Matthew-Bon/imx_pequena/notes/sd_boot.PNG

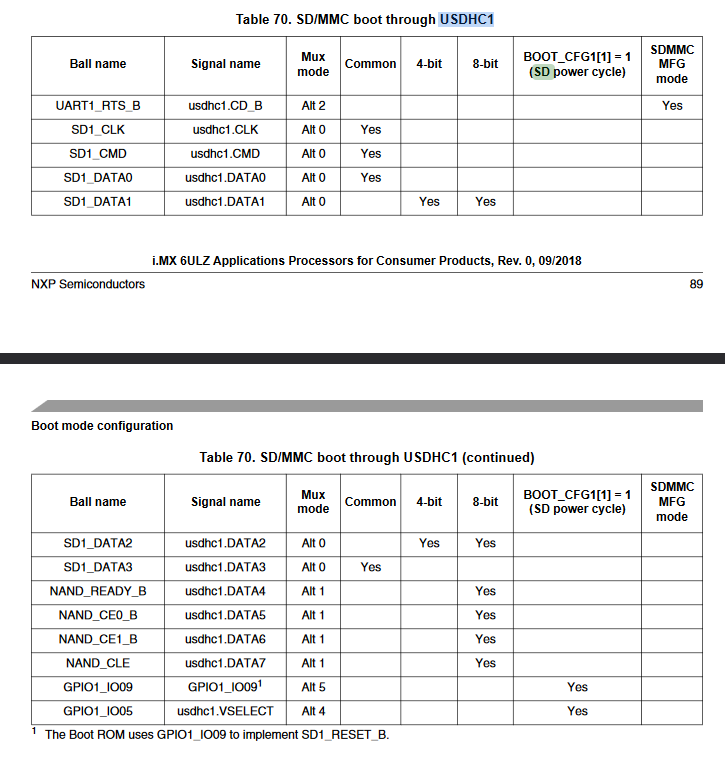
notes/sd_boot.PNG
