Matthew-Bon/imx_pequena/imx_pequena/imx_pequena.kicad_pcb

## KiCad design imx_pequena/imx_pequena.kicad_pcb (2024-03-02)

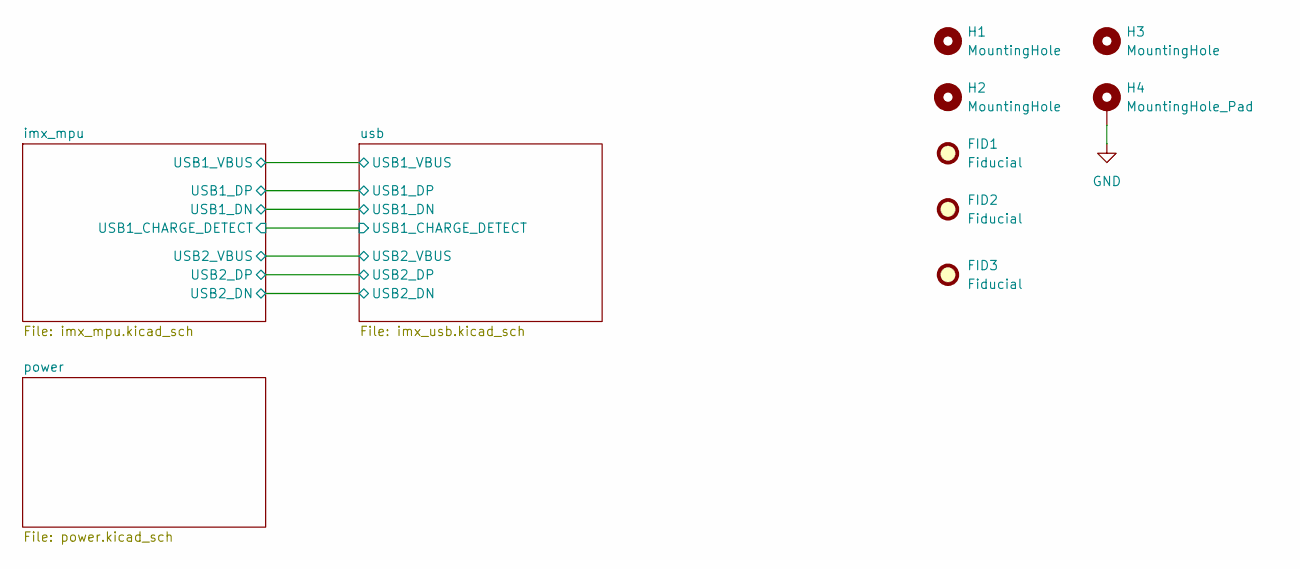
[picture p2: schematic imx_pequena.kicad_sch]

Parts:
FID1, FID2, FID3: Fiducial; Fiducial_1mm_Mask2mm
H1, H2, H3: MountingHole; MountingHole_2.5mm
H4: MountingHole_Pad; MountingHole_2.5mm_Pad

Connections:
GND: H4.1; also elsewhere on the board

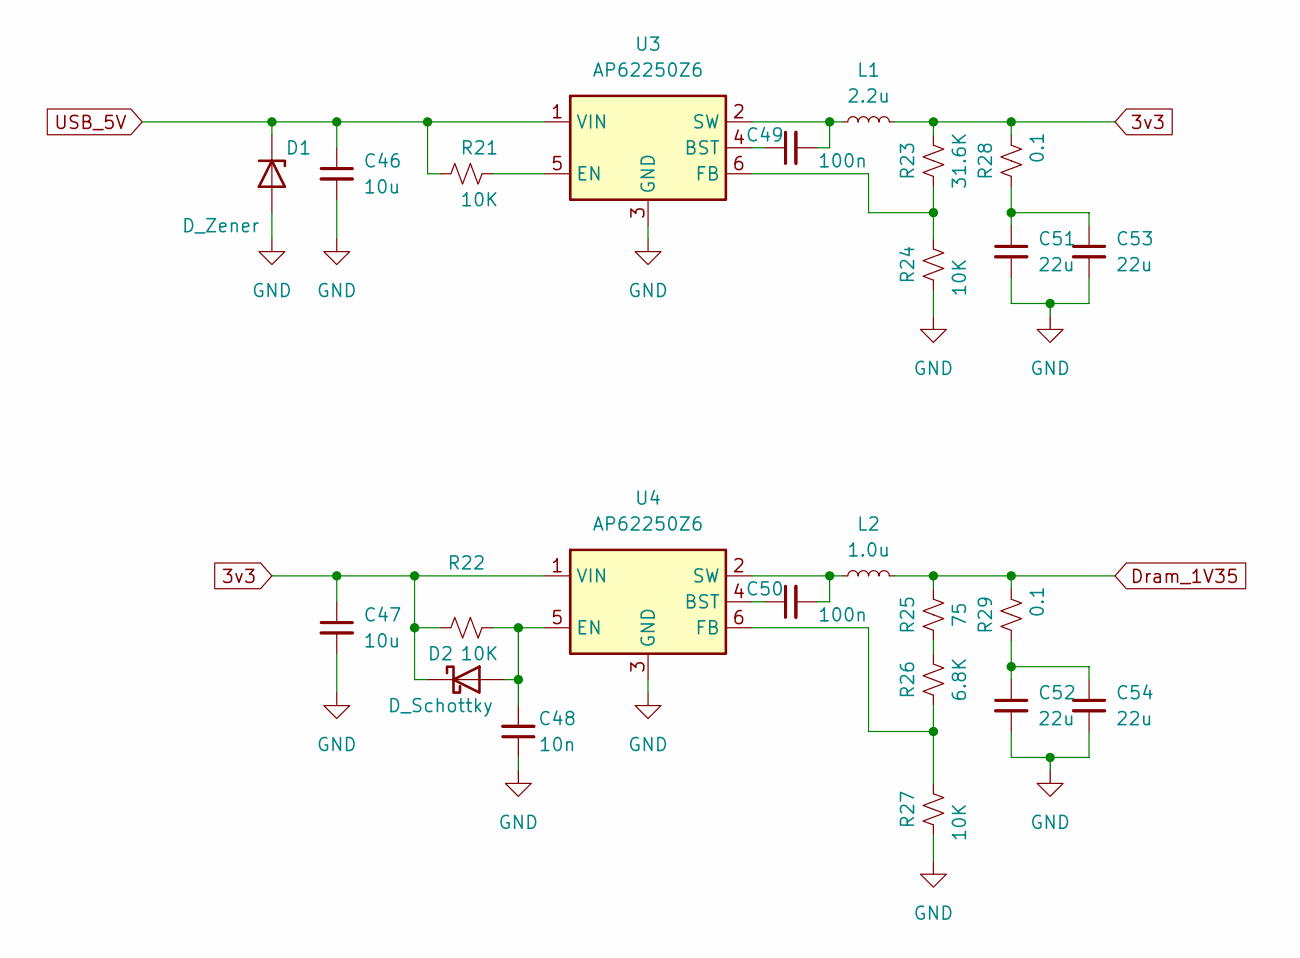
[picture p3: schematic power.kicad_sch]

Parts:
C46, C47: 10u; C_0805_2012Metric
C48: 10n; C_0805_2012Metric
C49, C50: 100n; C_0402_1005Metric
C51, C52, C53, C54: 22u; C_0805_2012Metric
D1: D_Zener; D_SOD-123
D2: D_Schottky; D_SOD-123
L1: 2.2u; L_Bourns_SRP5030T
L2: 1.0u; L_Bourns_SRP5030T
R21, R22, R24, R27: 10K; R_0402_1005Metric
R23: 31.6K; R_0402_1005Metric
R25: 75; R_0402_1005Metric
R26: 6.8K; R_0402_1005Metric
R28, R29: 0.1; R_0805_2012Metric
U3, U4: AP62250Z6; SOT-563

Connections:
3v3: C47.1, D2.1 (K), L1.2, R22.1, R23.2, R28.2, U4.1 (VIN); also elsewhere on the board
Dram_1V35: L2.2, R25.2, R29.2; also elsewhere on the board
GND: C46.2, C47.2, C48.1, C51.2, C52.2, C53.2, C54.2, D1.2 (A), R24.1, R27.1, U3.3 (GND), U4.3 (GND); also elsewhere on the board
unnamed: C48.2, D2.2 (A), R22.2, U4.5 (EN)
unnamed: C49.1, U3.4 (BST)
unnamed: C49.2, L1.1, U3.2 (SW)
unnamed: C50.1, U4.4 (BST)
unnamed: C50.2, L2.1, U4.2 (SW)
unnamed: C51.1, C53.1, R28.1
unnamed: C52.1, C54.1, R29.1
unnamed: R21.2, U3.5 (EN)
unnamed: R23.1, R24.2, U3.6 (FB)
unnamed: R25.1, R26.2
unnamed: R26.1, R27.2, U4.6 (FB)
USB_5V: C46.1, D1.1 (K), R21.1, U3.1 (VIN)

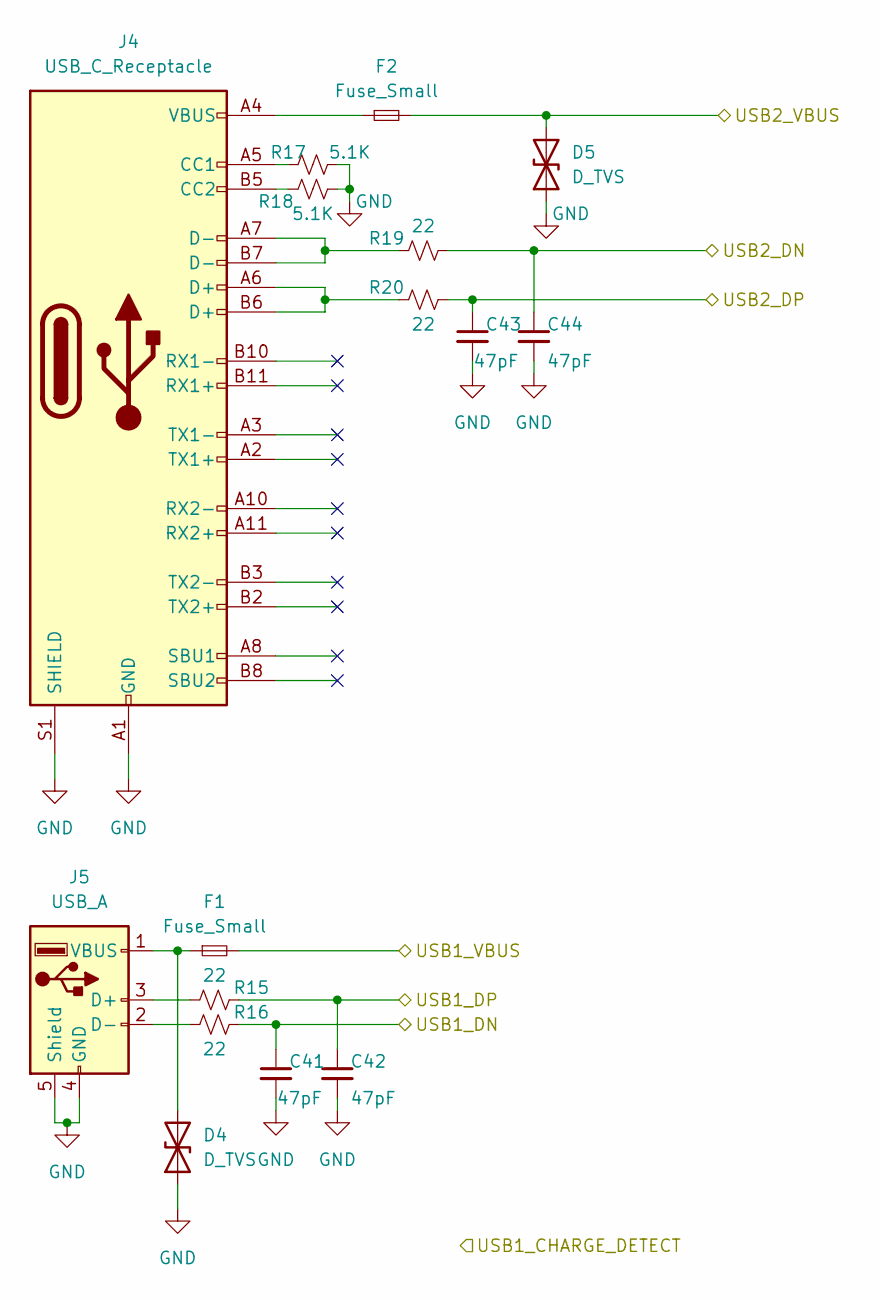
[picture p4: schematic imx_usb.kicad_sch]

Parts:
C41, C42, C43, C44: 47pF; C_0402_1005Metric
D4, D5: D_TVS; D_SOD-123
F1, F2: Fuse_Small; R_1206_3216Metric
J4: USB_C_Receptacle; USB_C_Receptacle_Amphenol_12401610E4-2A_CircularHoles
J5: USB_A; USB_A_Molex_67643_Horizontal
R15, R16, R19, R20: 22; R_0402_1005Metric
R17, R18: 5.1K; R_0402_1005Metric

Connections:
/imx_mpu/USB1_DN: C41.1, R16.2; also elsewhere on the board
/imx_mpu/USB1_DP: C42.1, R15.2; also elsewhere on the board
/imx_mpu/USB1_VBUS: F1.2; also elsewhere on the board
/imx_mpu/USB2_DN: C44.1, R19.2; also elsewhere on the board
/imx_mpu/USB2_DP: C43.1, R20.2; also elsewhere on the board
/imx_mpu/USB2_VBUS: D5.2 (A2), F2.2; also elsewhere on the board
GND: C41.2, C42.2, C43.2, C44.2, D4.1 (A1), D5.1 (A1), J4.A1 (GND), J4.A12 (GND), J4.B1 (GND), J4.B12 (GND), J4.S1 (SHIELD), J5.4 (GND), J5.5 (Shield), R17.2, R18.2; also elsewhere on the board
unnamed: D4.2 (A2), F1.1, J5.1 (VBUS)
unnamed: F2.1, J4.A4 (VBUS), J4.A9 (VBUS), J4.B4 (VBUS), J4.B9 (VBUS)
unnamed: J4.A5 (CC1), R17.1
unnamed: J4.A6 (D+), J4.B6 (D+), R20.1
unnamed: J4.A7 (D-), J4.B7 (D-), R19.1
unnamed: J4.B5 (CC2), R18.1
unnamed: J5.2 (D-), R16.1
unnamed: J5.3 (D+), R15.1

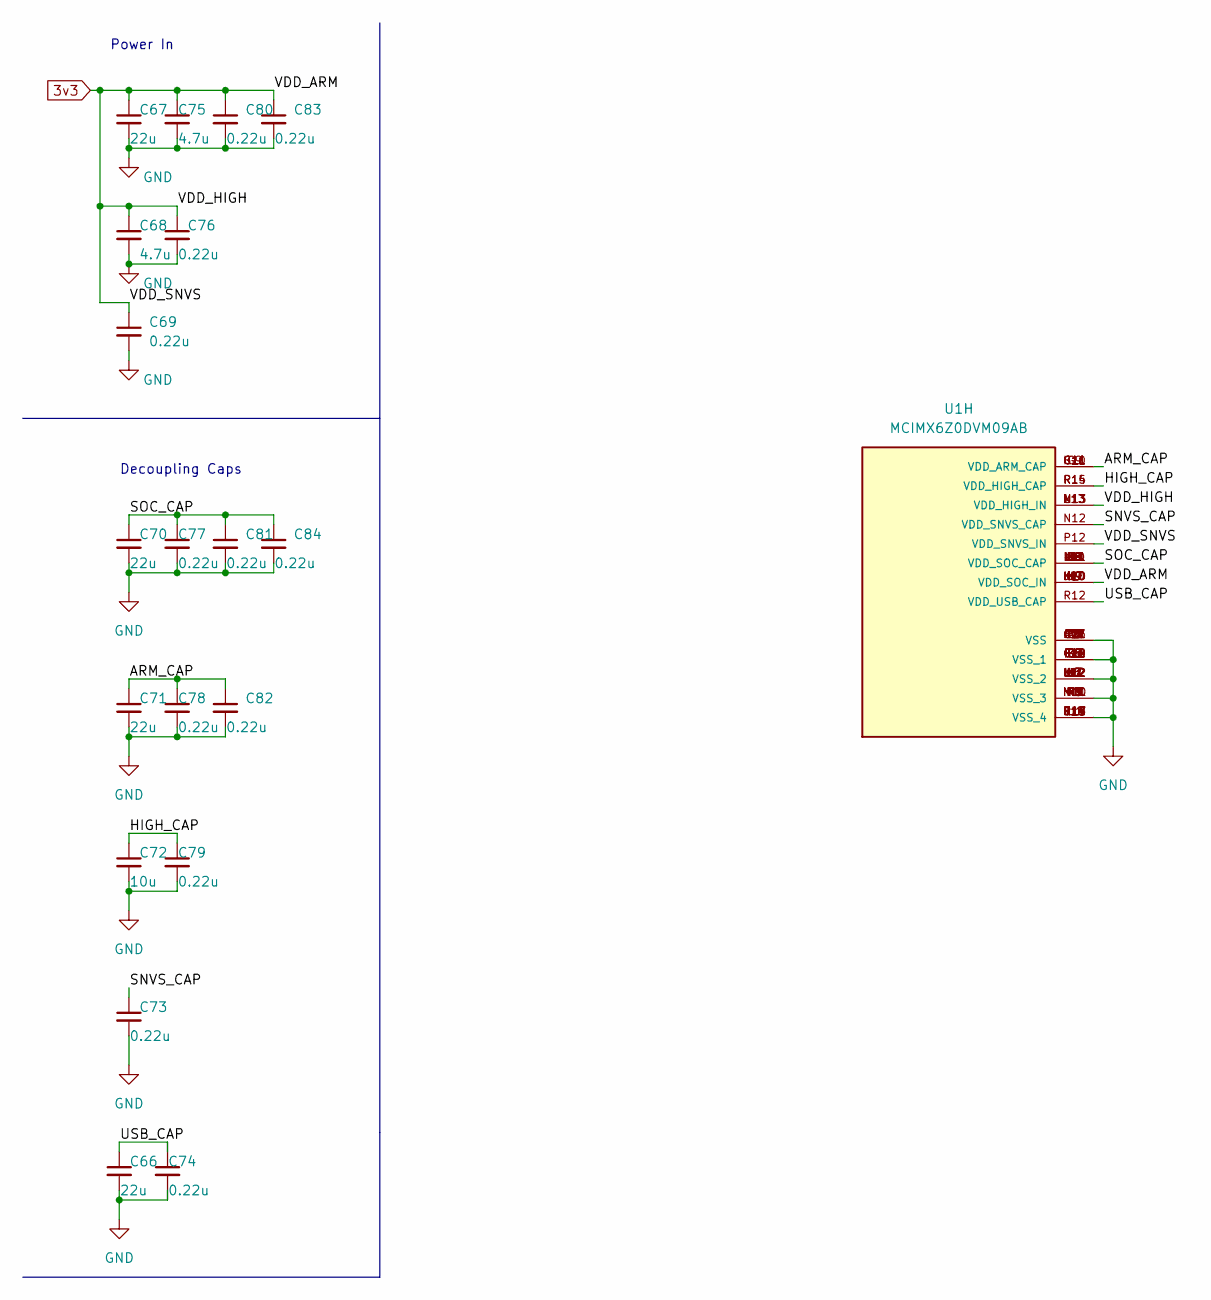
[picture p5: schematic mpu_h_power.kicad_sch]

Parts:
C66, C67, C70, C71: 22u; C_0805_2012Metric
C68, C75: 4.7u; C_0805_2012Metric
C69, C73, C74, C76, C77, C78, C79, C80, C81, C82, C83, C84: 0.22u; C_0402_1005Metric
C72: 10u; C_0805_2012Metric
U1: MCIMX6Z0DVM09AB; BGA289C80P17X17_1400X1400X132; PARTREV 0

Connections:
3v3: C67.1, C68.1, C69.1, C75.1, C76.1, C80.1, C83.1, U1.H9 (VDD_SOC_IN), U1.H10 (VDD_SOC_IN), U1.J9 (VDD_SOC_IN), U1.J10 (VDD_SOC_IN), U1.K9 (VDD_SOC_IN), U1.K10 (VDD_SOC_IN), U1.L13 (VDD_HIGH_IN), U1.M13 (VDD_HIGH_IN), U1.N13 (VDD_HIGH_IN), U1.P12 (VDD_SNVS_IN); also elsewhere on the board
/imx_mpu/mpu_h_power/ARM_CAP: C71.1, C78.1, C82.1, U1.G9 (VDD_ARM_CAP), U1.G10 (VDD_ARM_CAP), U1.G11 (VDD_ARM_CAP), U1.H11 (VDD_ARM_CAP)
/imx_mpu/mpu_h_power/HIGH_CAP: C72.1, C79.1, U1.R14 (VDD_HIGH_CAP), U1.R15 (VDD_HIGH_CAP)
/imx_mpu/mpu_h_power/SNVS_CAP: C73.1, U1.N12 (VDD_SNVS_CAP)
/imx_mpu/mpu_h_power/SOC_CAP: C70.1, C77.1, C81.1, C84.1, U1.G8 (VDD_SOC_CAP), U1.H8 (VDD_SOC_CAP), U1.J8 (VDD_SOC_CAP), U1.J11 (VDD_SOC_CAP), U1.K8 (VDD_SOC_CAP), U1.K11 (VDD_SOC_CAP), U1.L8 (VDD_SOC_CAP), U1.L9 (VDD_SOC_CAP), U1.L10 (VDD_SOC_CAP), U1.L11 (VDD_SOC_CAP)
/imx_mpu/mpu_h_power/USB_CAP: C66.1, C74.1, U1.R12 (VDD_USB_CAP)
GND: C66.2, C67.2, C68.2, C69.2, C70.2, C71.2, C72.2, C73.2, C74.2, C75.2, C76.2, C77.2, C78.2, C79.2, C80.2, C81.2, C82.2, C83.2, C84.2, U1.A1 (VSS), U1.A17 (VSS), U1.C3 (VSS), U1.C7 (VSS), U1.C11 (VSS), U1.C15 (VSS), U1.E8 (VSS), U1.E11 (VSS), U1.F6 (VSS), U1.F7 (VSS), U1.F8 (VSS_1), U1.F9 (VSS_1), U1.F10 (VSS_1), U1.F11 (VSS_1), U1.F12 (VSS_1), U1.G3 (VSS_1), U1.G5 (VSS_1), U1.G7 (VSS_1), U1.G12 (VSS_1), U1.G15 (VSS_1), U1.H7 (VSS_2), U1.H12 (VSS_2), U1.J5 (VSS_2), U1.J7 (VSS_2), U1.J12 (VSS_2), U1.K7 (VSS_2), U1.K12 (VSS_2), U1.L3 (VSS_2), U1.L7 (VSS_2), U1.L12 (VSS_2), U1.M7 (VSS_3), U1.M8 (VSS_3), U1.M9 (VSS_3), U1.M10 (VSS_3), U1.M11 (VSS_3), U1.N3 (VSS_3), U1.N5 (VSS_3), U1.R3 (VSS_3), U1.R5 (VSS_3), U1.R7 (VSS_3), U1.R11 (VSS_4), U1.R16 (VSS_4), U1.R17 (VSS_4), U1.T14 (VSS_4), U1.U1 (VSS_4), U1.U14 (VSS_4), U1.U17 (VSS_4); also elsewhere on the board

Notes on the sheet:
Power In
Decoupling Caps

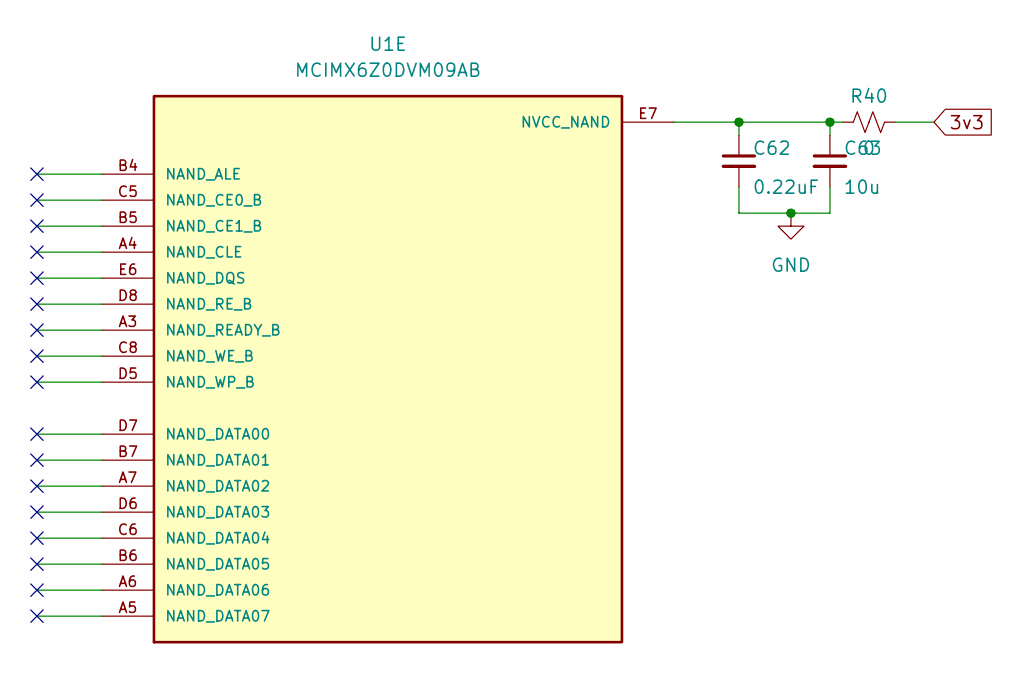
[picture p6: schematic mpu_e_nand.kicad_sch]

Parts:
C62: 0.22uF; C_0402_1005Metric
C63: 10u; C_0805_2012Metric
R40: 0; R_0402_1005Metric
U1: MCIMX6Z0DVM09AB; BGA289C80P17X17_1400X1400X132; PARTREV 0

Connections:
3v3: R40.2; also elsewhere on the board
GND: C62.2, C63.2; also elsewhere on the board
unnamed: C62.1, C63.1, R40.1, U1.E7 (NVCC_NAND)

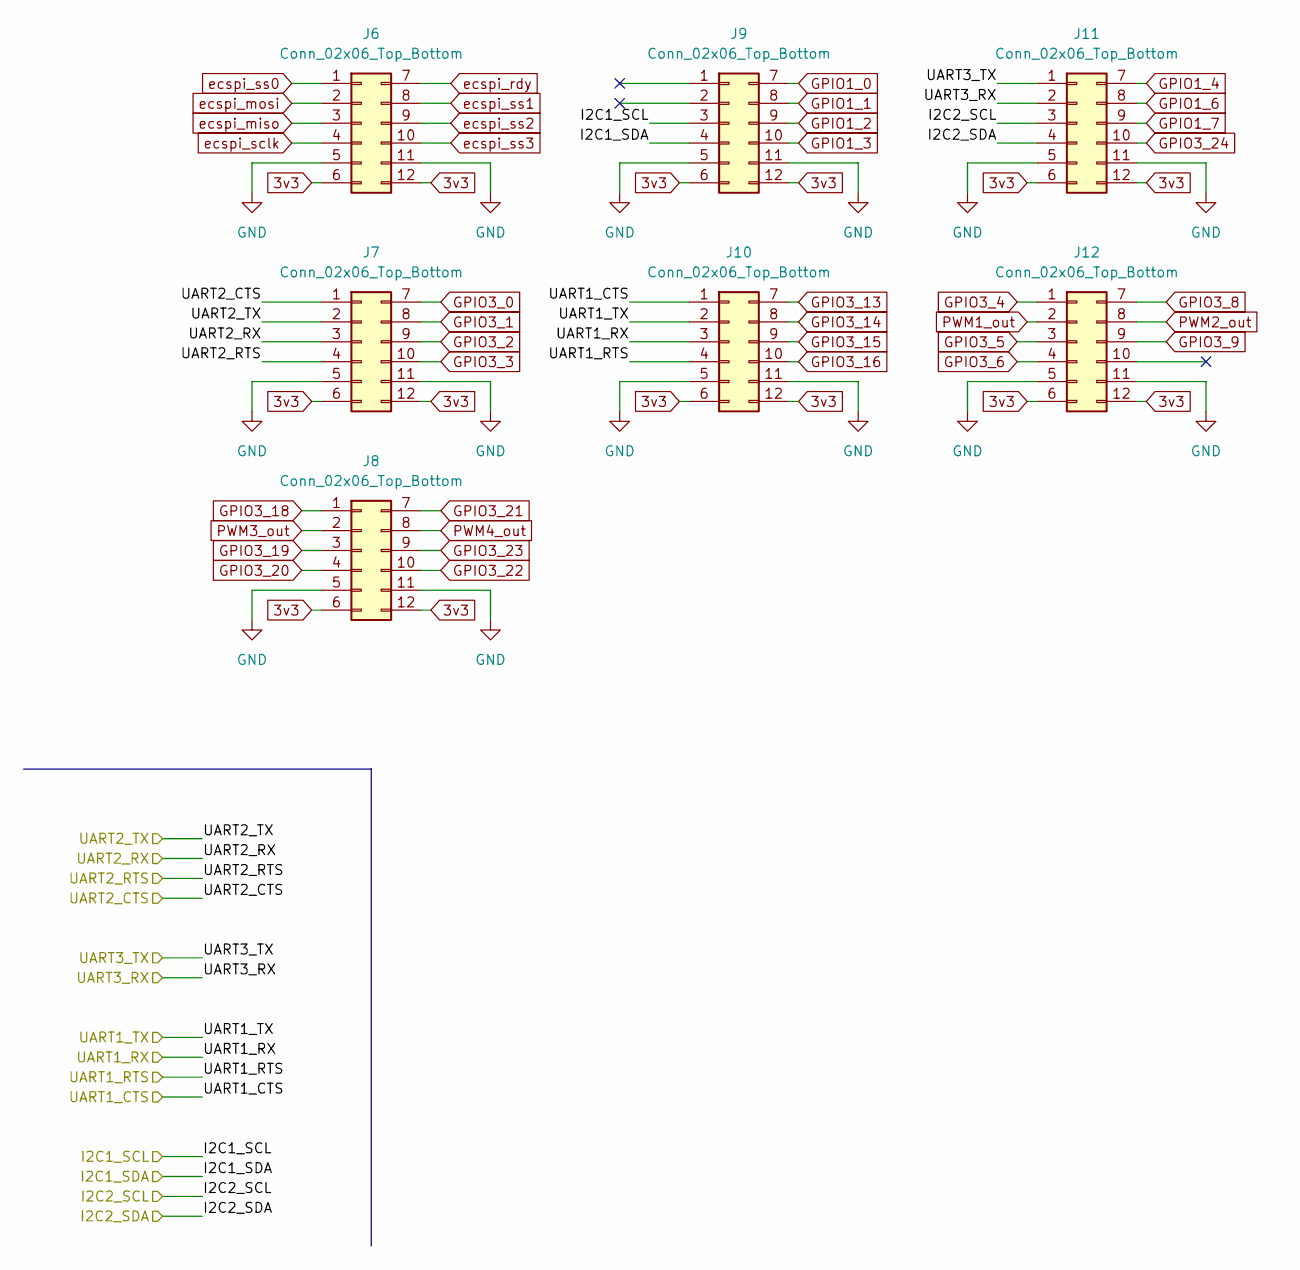
[picture p7: schematic pinouts.kicad_sch]

Parts:
J6, J7, J8, J9, J10, J11, J12: Conn_02x06_Top_Bottom; PinSocket_2x06_P2.54mm_Horizontal

Connections:
3v3: J6.6, J6.12, J7.6, J7.12, J8.6, J8.12, J9.6, J9.12, J10.6, J10.12, J11.6, J11.12, J12.6, J12.12; also elsewhere on the board
/imx_mpu/I2C1_SCL: J9.3; also elsewhere on the board
/imx_mpu/I2C1_SDA: J9.4; also elsewhere on the board
/imx_mpu/I2C2_SCL: J11.3; also elsewhere on the board
/imx_mpu/I2C2_SDA: J11.4; also elsewhere on the board
/imx_mpu/UART1_CTS: J10.1; also elsewhere on the board
/imx_mpu/UART1_RTS: J10.4; also elsewhere on the board
/imx_mpu/UART1_RX: J10.3; also elsewhere on the board
/imx_mpu/UART1_TX: J10.2; also elsewhere on the board
/imx_mpu/UART2_CTS: J7.1; also elsewhere on the board
/imx_mpu/UART2_RTS: J7.4; also elsewhere on the board
/imx_mpu/UART2_RX: J7.3; also elsewhere on the board
/imx_mpu/UART2_TX: J7.2; also elsewhere on the board
/imx_mpu/UART3_RX: J11.2; also elsewhere on the board
/imx_mpu/UART3_TX: J11.1; also elsewhere on the board
GND: J6.5, J6.11, J7.5, J7.11, J8.5, J8.11, J9.5, J9.11, J10.5, J10.11, J11.5, J11.11, J12.5, J12.11; also elsewhere on the board
GPIO1_0: J9.7; also elsewhere on the board
GPIO1_1: J9.8; also elsewhere on the board
GPIO1_2: J9.9; also elsewhere on the board
GPIO1_3: J9.10; also elsewhere on the board
GPIO1_4: J11.7; also elsewhere on the board
GPIO1_6: J11.8; also elsewhere on the board
GPIO1_7: J11.9; also elsewhere on the board
GPIO3_0: J7.7; also elsewhere on the board
GPIO3_1: J7.8; also elsewhere on the board
GPIO3_2: J7.9; also elsewhere on the board
GPIO3_3: J7.10; also elsewhere on the board
GPIO3_4: J12.1; also elsewhere on the board
GPIO3_5: J12.3; also elsewhere on the board
GPIO3_6: J12.4; also elsewhere on the board
GPIO3_8: J12.7; also elsewhere on the board
GPIO3_9: J12.9; also elsewhere on the board
GPIO3_13: J10.7; also elsewhere on the board
GPIO3_14: J10.8; also elsewhere on the board
GPIO3_15: J10.9; also elsewhere on the board
GPIO3_16: J10.10; also elsewhere on the board
GPIO3_18: J8.1; also elsewhere on the board
GPIO3_19: J8.3; also elsewhere on the board
GPIO3_20: J8.4; also elsewhere on the board
GPIO3_21: J8.7; also elsewhere on the board
GPIO3_22: J8.10; also elsewhere on the board
GPIO3_23: J8.9; also elsewhere on the board
GPIO3_24: J11.10; also elsewhere on the board
PWM1_out: J12.2; also elsewhere on the board
PWM2_out: J12.8; also elsewhere on the board
PWM3_out: J8.2; also elsewhere on the board
PWM4_out: J8.8; also elsewhere on the board
ecspi_miso: J6.3; also elsewhere on the board
ecspi_mosi: J6.2; also elsewhere on the board
ecspi_rdy: J6.7; also elsewhere on the board
ecspi_sclk: J6.4; also elsewhere on the board
ecspi_ss0: J6.1; also elsewhere on the board
ecspi_ss1: J6.8; also elsewhere on the board
ecspi_ss2: J6.9; also elsewhere on the board
ecspi_ss3: J6.10; also elsewhere on the board

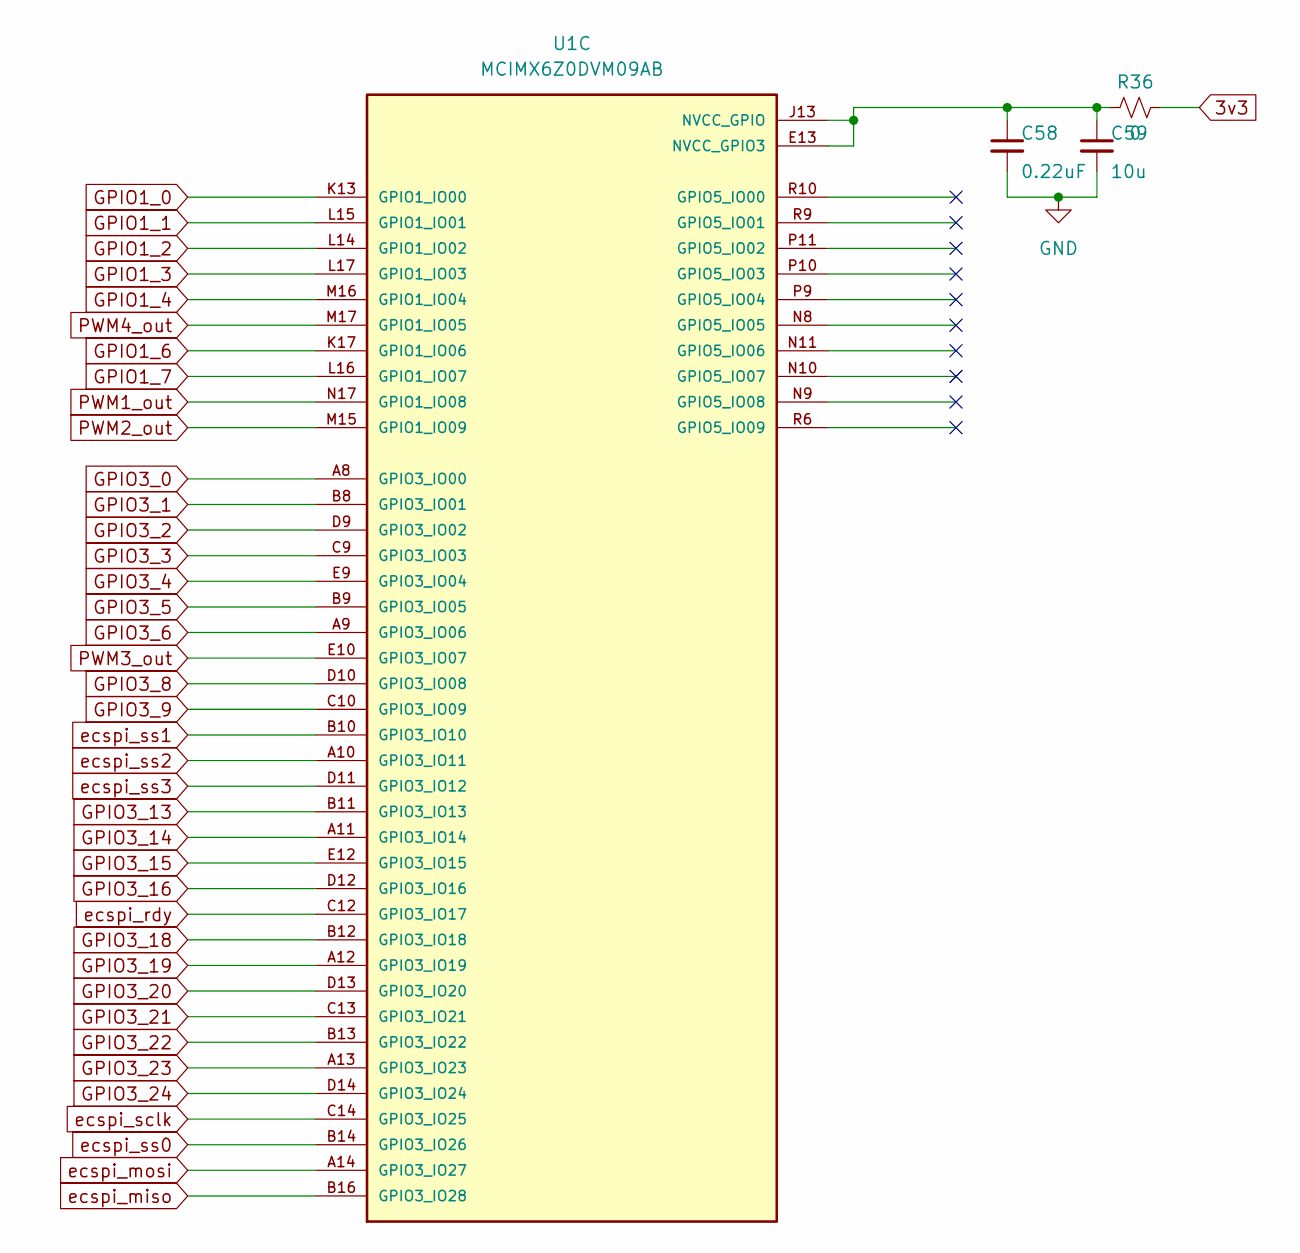
[picture p8: schematic mpu_c_gpio.kicad_sch]

Parts:
C58: 0.22uF; C_0402_1005Metric
C59: 10u; C_0805_2012Metric
R36: 0; R_0402_1005Metric
U1: MCIMX6Z0DVM09AB; BGA289C80P17X17_1400X1400X132; PARTREV 0

Connections:
3v3: R36.2; also elsewhere on the board
GND: C58.2, C59.2; also elsewhere on the board
GPIO1_0: U1.K13 (GPIO1_IO00); also elsewhere on the board
GPIO1_1: U1.L15 (GPIO1_IO01); also elsewhere on the board
GPIO1_2: U1.L14 (GPIO1_IO02); also elsewhere on the board
GPIO1_3: U1.L17 (GPIO1_IO03); also elsewhere on the board
GPIO1_4: U1.M16 (GPIO1_IO04); also elsewhere on the board
GPIO1_6: U1.K17 (GPIO1_IO06); also elsewhere on the board
GPIO1_7: U1.L16 (GPIO1_IO07); also elsewhere on the board
GPIO3_0: U1.A8 (GPIO3_IO00); also elsewhere on the board
GPIO3_1: U1.B8 (GPIO3_IO01); also elsewhere on the board
GPIO3_2: U1.D9 (GPIO3_IO02); also elsewhere on the board
GPIO3_3: U1.C9 (GPIO3_IO03); also elsewhere on the board
GPIO3_4: U1.E9 (GPIO3_IO04); also elsewhere on the board
GPIO3_5: U1.B9 (GPIO3_IO05); also elsewhere on the board
GPIO3_6: U1.A9 (GPIO3_IO06); also elsewhere on the board
GPIO3_8: U1.D10 (GPIO3_IO08); also elsewhere on the board
GPIO3_9: U1.C10 (GPIO3_IO09); also elsewhere on the board
GPIO3_13: U1.B11 (GPIO3_IO13); also elsewhere on the board
GPIO3_14: U1.A11 (GPIO3_IO14); also elsewhere on the board
GPIO3_15: U1.E12 (GPIO3_IO15); also elsewhere on the board
GPIO3_16: U1.D12 (GPIO3_IO16); also elsewhere on the board
GPIO3_18: U1.B12 (GPIO3_IO18); also elsewhere on the board
GPIO3_19: U1.A12 (GPIO3_IO19); also elsewhere on the board
GPIO3_20: U1.D13 (GPIO3_IO20); also elsewhere on the board
GPIO3_21: U1.C13 (GPIO3_IO21); also elsewhere on the board
GPIO3_22: U1.B13 (GPIO3_IO22); also elsewhere on the board
GPIO3_23: U1.A13 (GPIO3_IO23); also elsewhere on the board
GPIO3_24: U1.D14 (GPIO3_IO24); also elsewhere on the board
unnamed: C58.1, C59.1, R36.1, U1.E13 (NVCC_GPIO3), U1.J13 (NVCC_GPIO)
PWM1_out: U1.N17 (GPIO1_IO08); also elsewhere on the board
PWM2_out: U1.M15 (GPIO1_IO09); also elsewhere on the board
PWM3_out: U1.E10 (GPIO3_IO07); also elsewhere on the board
PWM4_out: U1.M17 (GPIO1_IO05); also elsewhere on the board
ecspi_miso: U1.B16 (GPIO3_IO28); also elsewhere on the board
ecspi_mosi: U1.A14 (GPIO3_IO27); also elsewhere on the board
ecspi_rdy: U1.C12 (GPIO3_IO17); also elsewhere on the board
ecspi_sclk: U1.C14 (GPIO3_IO25); also elsewhere on the board
ecspi_ss0: U1.B14 (GPIO3_IO26); also elsewhere on the board
ecspi_ss1: U1.B10 (GPIO3_IO10); also elsewhere on the board
ecspi_ss2: U1.A10 (GPIO3_IO11); also elsewhere on the board
ecspi_ss3: U1.D11 (GPIO3_IO12); also elsewhere on the board

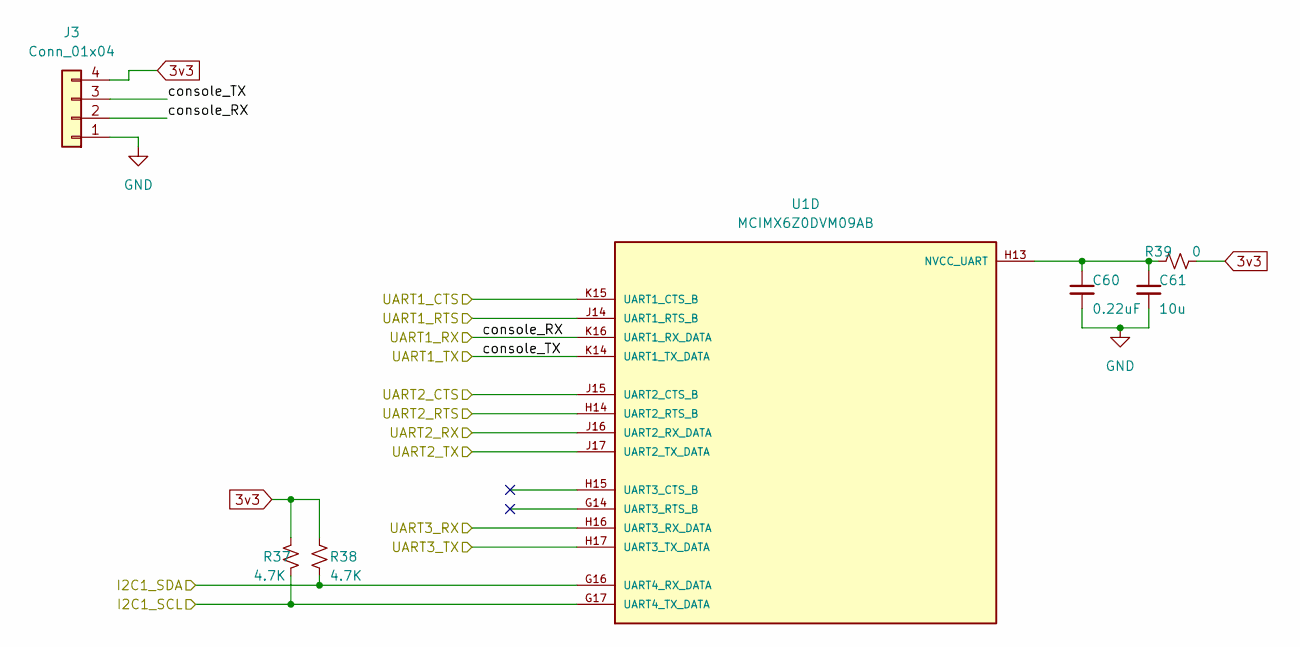
[picture p9: schematic mpu_d_uart.kicad_sch]

Parts:
C60: 0.22uF; C_0402_1005Metric
C61: 10u; C_0805_2012Metric
J3: Conn_01x04; PinHeader_1x04_P2.54mm_Vertical
R37, R38: 4.7K; R_0402_1005Metric
R39: 0; R_0402_1005Metric
U1: MCIMX6Z0DVM09AB; BGA289C80P17X17_1400X1400X132; PARTREV 0

Connections:
3v3: J3.4, R37.1, R38.1, R39.2; also elsewhere on the board
/imx_mpu/I2C1_SCL: R37.2, U1.G17 (UART4_TX_DATA); also elsewhere on the board
/imx_mpu/I2C1_SDA: R38.2, U1.G16 (UART4_RX_DATA); also elsewhere on the board
/imx_mpu/UART1_CTS: U1.J14 (UART1_RTS_B); also elsewhere on the board
/imx_mpu/UART1_RTS: U1.K15 (UART1_CTS_B); also elsewhere on the board
/imx_mpu/UART1_RX: J3.2, U1.K16 (UART1_RX_DATA); also elsewhere on the board
/imx_mpu/UART1_TX: J3.3, U1.K14 (UART1_TX_DATA); also elsewhere on the board
/imx_mpu/UART2_CTS: U1.J15 (UART2_CTS_B); also elsewhere on the board
/imx_mpu/UART2_RTS: U1.H14 (UART2_RTS_B); also elsewhere on the board
/imx_mpu/UART2_RX: U1.J16 (UART2_RX_DATA); also elsewhere on the board
/imx_mpu/UART2_TX: U1.J17 (UART2_TX_DATA); also elsewhere on the board
/imx_mpu/UART3_RX: U1.H16 (UART3_RX_DATA); also elsewhere on the board
/imx_mpu/UART3_TX: U1.H17 (UART3_TX_DATA); also elsewhere on the board
GND: C60.2, C61.2, J3.1; also elsewhere on the board
unnamed: C60.1, C61.1, R39.1, U1.H13 (NVCC_UART)

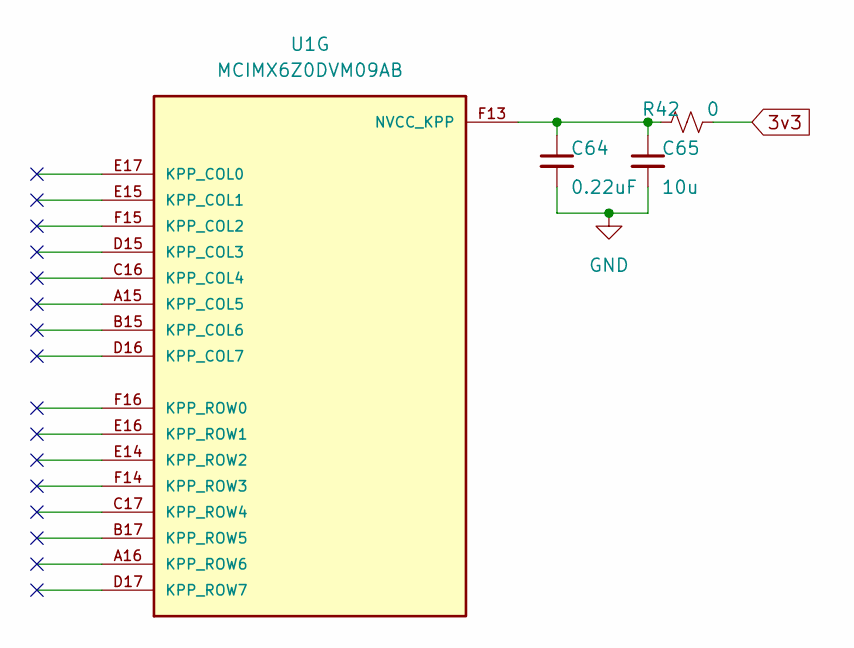
[picture p10: schematic mpu_g_kpp.kicad_sch]

Parts:
C64: 0.22uF; C_0402_1005Metric
C65: 10u; C_0805_2012Metric
R42: 0; R_0402_1005Metric
U1: MCIMX6Z0DVM09AB; BGA289C80P17X17_1400X1400X132; PARTREV 0

Connections:
3v3: R42.2; also elsewhere on the board
GND: C64.2, C65.2; also elsewhere on the board
unnamed: C64.1, C65.1, R42.1, U1.F13 (NVCC_KPP)

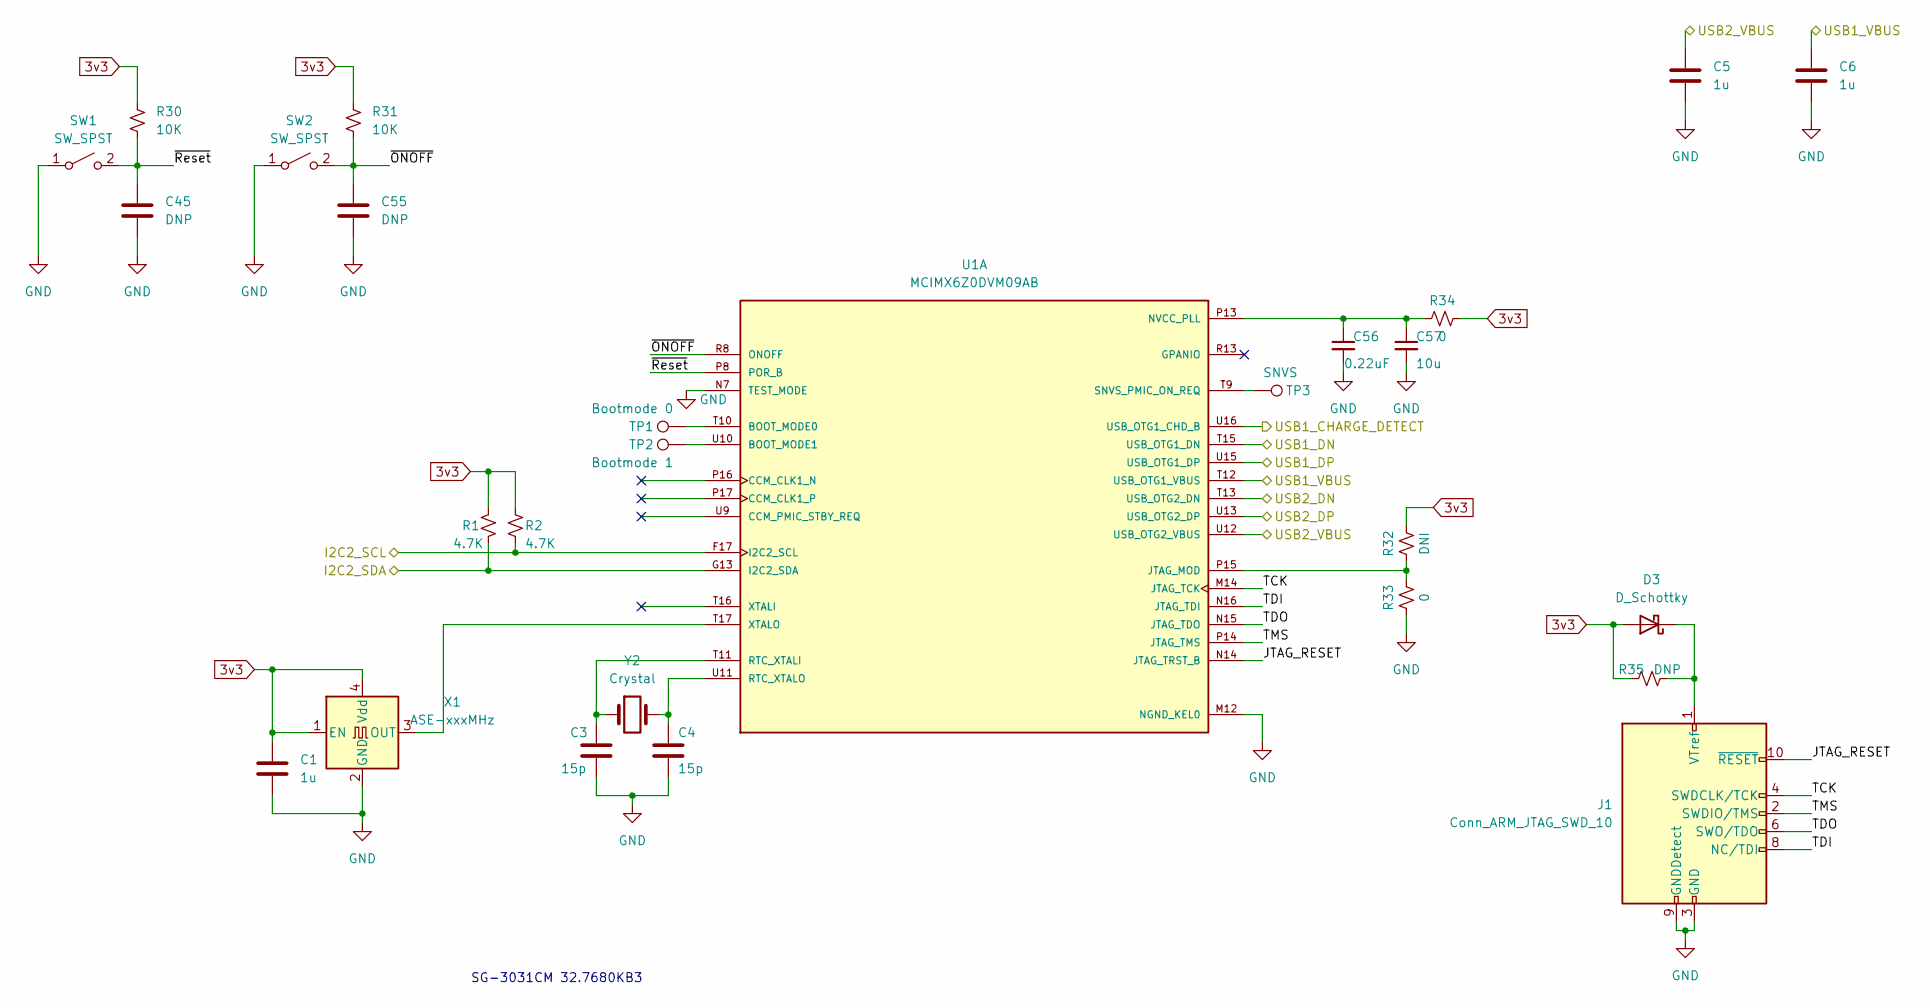
[picture p11: schematic mpu_a_io.kicad_sch]

Parts:
C1, C5, C6: 1u; C_0603_1608Metric
C3, C4: 15p; C_0402_1005Metric
C45: DNP; C_0402_1005Metric
C55: DNP; C_0805_2012Metric
C56: 0.22uF; C_0402_1005Metric
C57: 10u; C_0805_2012Metric
D3: D_Schottky; D_SOD-123
J1: Conn_ARM_JTAG_SWD_10; PinHeader_2x05_P1.27mm_Vertical
R1, R2: 4.7K; R_0402_1005Metric
R30, R31: 10K; R_0402_1005Metric
R32: DNI; R_0402_1005Metric
R33, R34: 0; R_0402_1005Metric
R35: DNP; R_0402_1005Metric
SW1, SW2: SW_SPST; SW_SPST_TL3342
TP1: Bootmode 0; TestPoint_Pad_1.0x1.0mm
TP2: Bootmode 1; TestPoint_Pad_1.0x1.0mm
TP3: SNVS; TestPoint_Pad_1.0x1.0mm
U1: MCIMX6Z0DVM09AB; BGA289C80P17X17_1400X1400X132; PARTREV 0
X1: ASE-xxxMHz; Oscillator_SMD_Abracon_ASE-4Pin_3.2x2.5mm
Y2: Crystal; Crystal_SMD_MicroCrystal_MS1V-T1K

Connections:
3v3: C1.1, D3.2 (A), R1.1, R2.1, R30.1, R31.1, R32.2, R34.2, R35.1, X1.1 (EN), X1.4 (Vdd); also elsewhere on the board
/imx_mpu/I2C2_SCL: R2.2, U1.F17 (I2C2_SCL); also elsewhere on the board
/imx_mpu/I2C2_SDA: R1.2, U1.G13 (I2C2_SDA); also elsewhere on the board
/imx_mpu/USB1_CHARGE_DETECT: U1.U16 (USB_OTG1_CHD_B)
/imx_mpu/USB1_DN: U1.T15 (USB_OTG1_DN); also elsewhere on the board
/imx_mpu/USB1_DP: U1.U15 (USB_OTG1_DP); also elsewhere on the board
/imx_mpu/USB1_VBUS: C6.1, U1.T12 (USB_OTG1_VBUS); also elsewhere on the board
/imx_mpu/USB2_DN: U1.T13 (USB_OTG2_DN); also elsewhere on the board
/imx_mpu/USB2_DP: U1.U13 (USB_OTG2_DP); also elsewhere on the board
/imx_mpu/USB2_VBUS: C5.1, U1.U12 (USB_OTG2_VBUS); also elsewhere on the board
/imx_mpu/mpu_a_io/JTAG_RESET: J1.10 (~RESET), U1.N14 (JTAG_TRST_B)
/imx_mpu/mpu_a_io/TCK: J1.4 (SWDCLK/TCK), U1.M14 (JTAG_TCK)
/imx_mpu/mpu_a_io/TDI: J1.8 (NC/TDI), U1.N16 (JTAG_TDI)
/imx_mpu/mpu_a_io/TDO: J1.6 (SWO/TDO), U1.N15 (JTAG_TDO)
/imx_mpu/mpu_a_io/TMS: J1.2 (SWDIO/TMS), U1.P14 (JTAG_TMS)
/imx_mpu/mpu_a_io/~ONOFF: C55.1, R31.2, SW2.2 (B), U1.R8 (ONOFF)
/imx_mpu/mpu_a_io/~Reset: C45.1, R30.2, SW1.2 (B), U1.P8 (POR_B)
GND: C1.2, C3.2, C4.2, C5.2, C6.2, C45.2, C55.2, C56.2, C57.2, J1.3 (GND), J1.5 (GND), J1.9 (GNDDetect), R33.1, SW1.1 (A), SW2.1 (A), U1.M12 (NGND_KEL0), U1.N7 (TEST_MODE), X1.2 (GND); also elsewhere on the board
unnamed: C3.1, U1.T11 (RTC_XTALI), Y2.1
unnamed: C4.1, U1.U11 (RTC_XTALO), Y2.2
unnamed: C56.1, C57.1, R34.1, U1.P13 (NVCC_PLL)
unnamed: D3.1 (K), J1.1 (VTref), R35.2
unnamed: R32.1, R33.2, U1.P15 (JTAG_MOD)
unnamed: TP1.1, U1.T10 (BOOT_MODE0)
unnamed: TP2.1, U1.U10 (BOOT_MODE1)
unnamed: TP3.1, U1.T9 (SNVS_PMIC_ON_REQ)
unnamed: U1.T17 (XTALO), X1.3 (OUT)

Notes on the sheet:
SG-3031CM 32.7680KB3

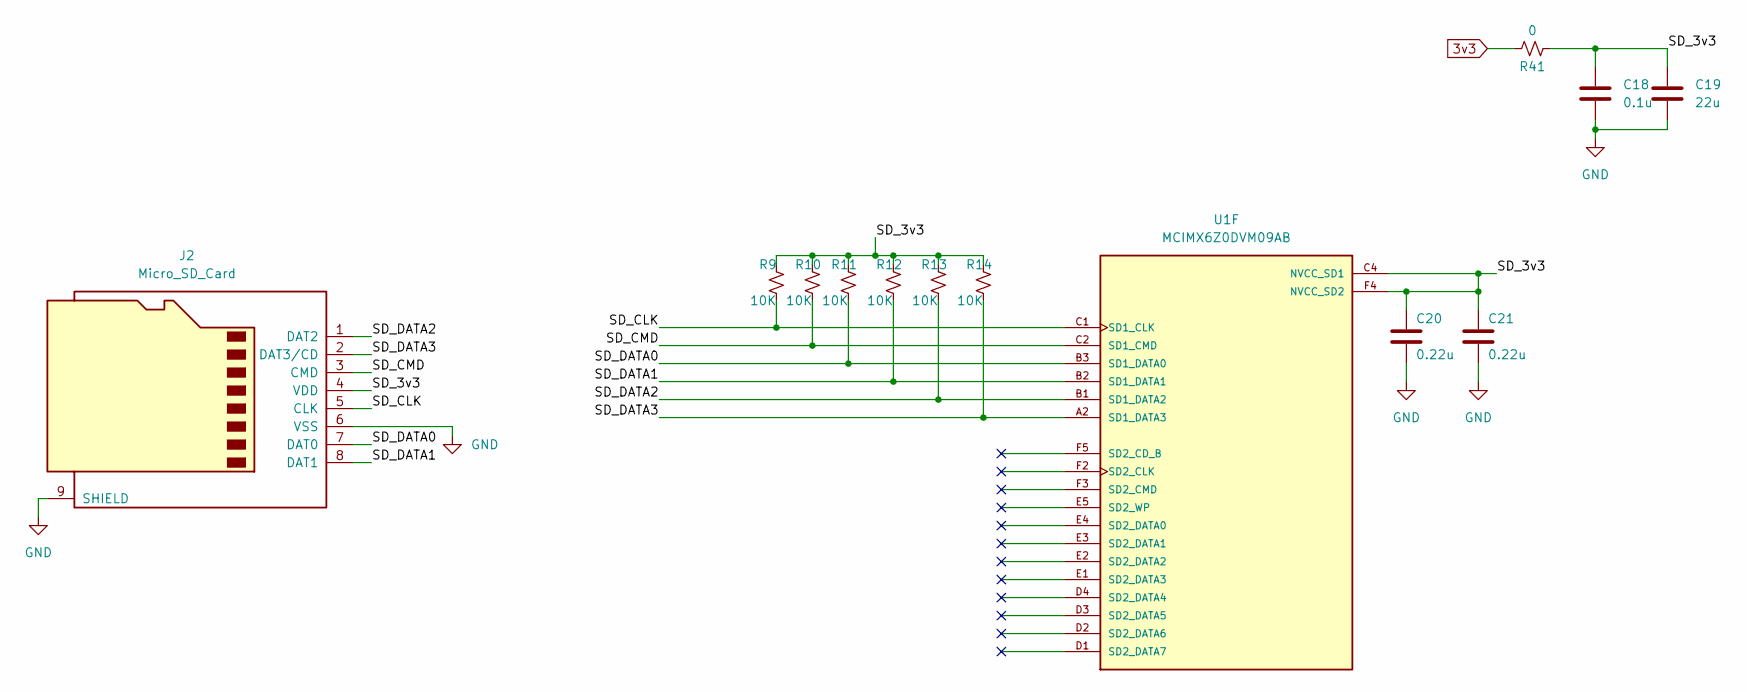
[picture p12: schematic mpu_f_sd.kicad_sch]

Parts:
C18: 0.1u; C_0402_1005Metric
C19: 22u; C_0805_2012Metric
C20, C21: 0.22u; C_0402_1005Metric
J2: Micro_SD_Card; microSD_HC_Hirose_DM3AT-SF-PEJM5
R9, R10, R11, R12, R13, R14: 10K; R_0402_1005Metric
R41: 0; R_0402_1005Metric
U1: MCIMX6Z0DVM09AB; BGA289C80P17X17_1400X1400X132; PARTREV 0

Connections:
3v3: R41.2; also elsewhere on the board
/imx_mpu/mpu_f_sd/SD_3v3: C18.1, C19.1, C20.1, C21.1, J2.4 (VDD), R9.1, R10.1, R11.1, R12.1, R13.1, R14.1, R41.1, U1.C4 (NVCC_SD1), U1.F4 (NVCC_SD2)
/imx_mpu/mpu_f_sd/SD_CLK: J2.5 (CLK), R9.2, U1.C1 (SD1_CLK)
/imx_mpu/mpu_f_sd/SD_CMD: J2.3 (CMD), R10.2, U1.C2 (SD1_CMD)
/imx_mpu/mpu_f_sd/SD_DATA0: J2.7 (DAT0), R11.2, U1.B3 (SD1_DATA0)
/imx_mpu/mpu_f_sd/SD_DATA1: J2.8 (DAT1), R12.2, U1.B2 (SD1_DATA1)
/imx_mpu/mpu_f_sd/SD_DATA2: J2.1 (DAT2), R13.2, U1.B1 (SD1_DATA2)
/imx_mpu/mpu_f_sd/SD_DATA3: J2.2 (DAT3/CD), R14.2, U1.A2 (SD1_DATA3)
GND: C18.2, C19.2, C20.2, C21.2, J2.6 (VSS), J2.9 (SHIELD); also elsewhere on the board
