Matthew-Bon/imx_pequena/imx_pequena/imx_pequena.kicad_pcb

## KiCad design imx_pequena/imx_pequena.kicad_pcb (continued)

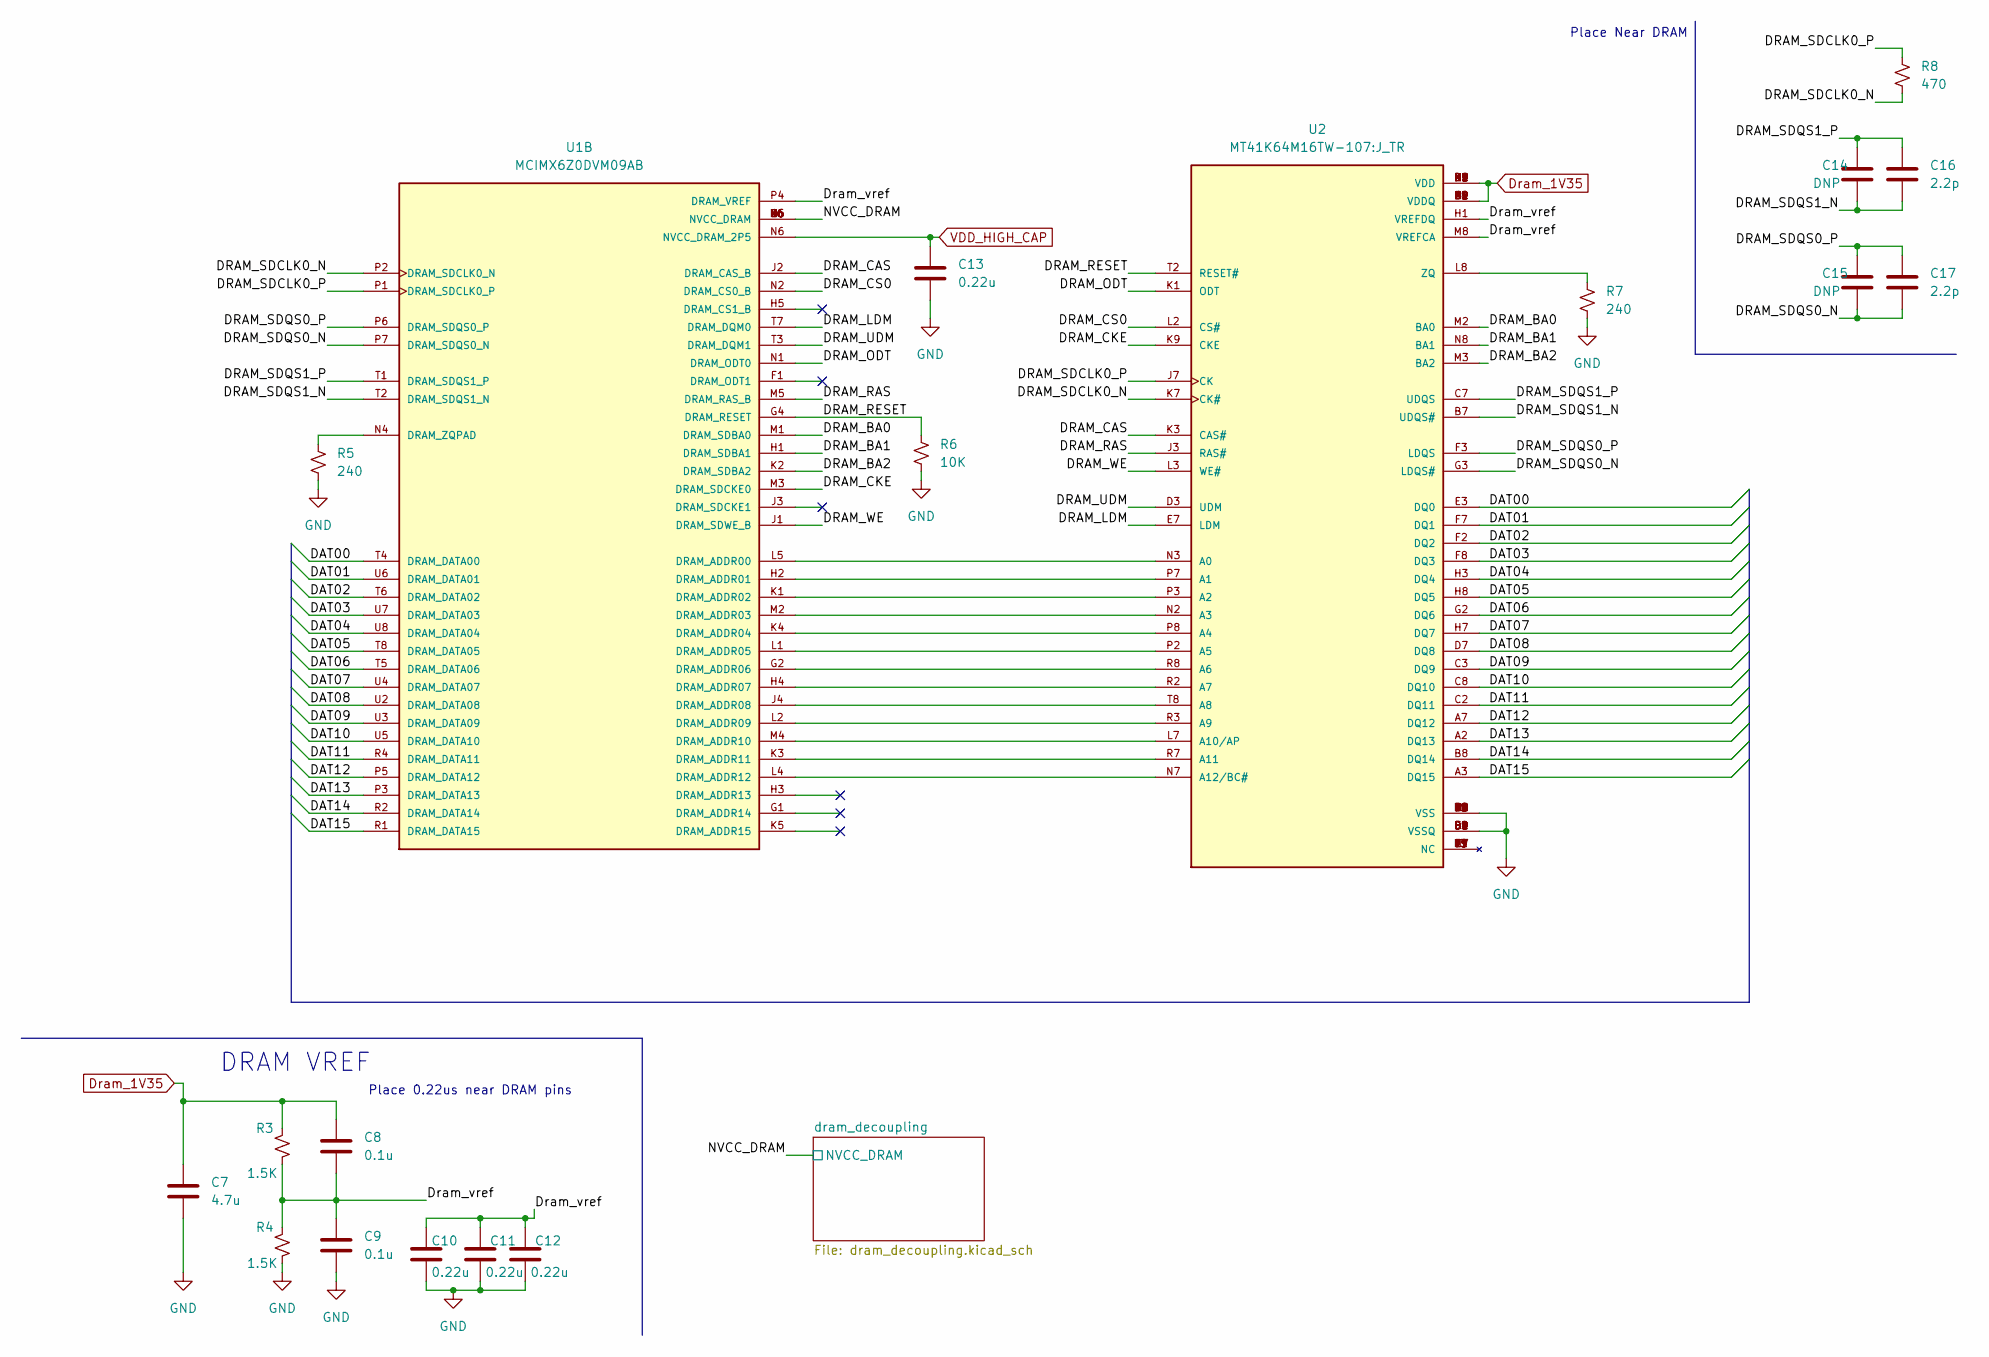
[picture p13: schematic mpu_b_dram.kicad_sch]

Parts:
C7: 4.7u; C_0603_1608Metric
C8, C9: 0.1u; C_0402_1005Metric
C10, C11, C12, C13: 0.22u; C_0402_1005Metric
C14, C15: DNP; C_0402_1005Metric
C16, C17: 2.2p; C_0402_1005Metric
R3, R4: 1.5K; R_0402_1005Metric
R5, R7: 240; R_0402_1005Metric
R6: 10K; R_0402_1005Metric
R8: 470; R_0402_1005Metric
U1: MCIMX6Z0DVM09AB; BGA289C80P17X17_1400X1400X132; PARTREV 0
U2: MT41K64M16TW-107:J_TR; BGA96C80P9X16_1400X800X120N; PARTREV Rev. L EN 9/18

Connections:
/imx_mpu/mpu_b_dram/DAT00: U1.T4 (DRAM_DATA00), U2.E3 (DQ0)
/imx_mpu/mpu_b_dram/DAT01: U1.U6 (DRAM_DATA01), U2.F7 (DQ1)
/imx_mpu/mpu_b_dram/DAT02: U1.T6 (DRAM_DATA02), U2.F2 (DQ2)
/imx_mpu/mpu_b_dram/DAT03: U1.U7 (DRAM_DATA03), U2.F8 (DQ3)
/imx_mpu/mpu_b_dram/DAT04: U1.U8 (DRAM_DATA04), U2.H3 (DQ4)
/imx_mpu/mpu_b_dram/DAT05: U1.T8 (DRAM_DATA05), U2.H8 (DQ5)
/imx_mpu/mpu_b_dram/DAT06: U1.T5 (DRAM_DATA06), U2.G2 (DQ6)
/imx_mpu/mpu_b_dram/DAT07: U1.U4 (DRAM_DATA07), U2.H7 (DQ7)
/imx_mpu/mpu_b_dram/DAT08: U1.U2 (DRAM_DATA08), U2.D7 (DQ8)
/imx_mpu/mpu_b_dram/DAT09: U1.U3 (DRAM_DATA09), U2.C3 (DQ9)
/imx_mpu/mpu_b_dram/DAT10: U1.U5 (DRAM_DATA10), U2.C8 (DQ10)
/imx_mpu/mpu_b_dram/DAT11: U1.R4 (DRAM_DATA11), U2.C2 (DQ11)
/imx_mpu/mpu_b_dram/DAT12: U1.P5 (DRAM_DATA12), U2.A7 (DQ12)
/imx_mpu/mpu_b_dram/DAT13: U1.P3 (DRAM_DATA13), U2.A2 (DQ13)
/imx_mpu/mpu_b_dram/DAT14: U1.R2 (DRAM_DATA14), U2.B8 (DQ14)
/imx_mpu/mpu_b_dram/DAT15: U1.R1 (DRAM_DATA15), U2.A3 (DQ15)
/imx_mpu/mpu_b_dram/DRAM_BA0: U1.M1 (DRAM_SDBA0), U2.M2 (BA0)
/imx_mpu/mpu_b_dram/DRAM_BA1: U1.H1 (DRAM_SDBA1), U2.N8 (BA1)
/imx_mpu/mpu_b_dram/DRAM_BA2: U1.K2 (DRAM_SDBA2), U2.M3 (BA2)
/imx_mpu/mpu_b_dram/DRAM_CAS: U1.J2 (DRAM_CAS_B), U2.K3 (CAS#)
/imx_mpu/mpu_b_dram/DRAM_CKE: U1.M3 (DRAM_SDCKE0), U2.K9 (CKE)
/imx_mpu/mpu_b_dram/DRAM_CS0: U1.N2 (DRAM_CS0_B), U2.L2 (CS#)
/imx_mpu/mpu_b_dram/DRAM_LDM: U1.T7 (DRAM_DQM0), U2.E7 (LDM)
/imx_mpu/mpu_b_dram/DRAM_ODT: U1.N1 (DRAM_ODT0), U2.K1 (ODT)
/imx_mpu/mpu_b_dram/DRAM_RAS: U1.M5 (DRAM_RAS_B), U2.J3 (RAS#)
/imx_mpu/mpu_b_dram/DRAM_RESET: R6.1, U1.G4 (DRAM_RESET), U2.T2 (RESET#)
/imx_mpu/mpu_b_dram/DRAM_SDCLK0_N: R8.2, U1.P2 (DRAM_SDCLK0_N), U2.K7 (CK#)
/imx_mpu/mpu_b_dram/DRAM_SDCLK0_P: R8.1, U1.P1 (DRAM_SDCLK0_P), U2.J7 (CK)
/imx_mpu/mpu_b_dram/DRAM_SDQS0_N: C15.2, C17.2, U1.P7 (DRAM_SDQS0_N), U2.G3 (LDQS#)
/imx_mpu/mpu_b_dram/DRAM_SDQS0_P: C15.1, C17.1, U1.P6 (DRAM_SDQS0_P), U2.F3 (LDQS)
/imx_mpu/mpu_b_dram/DRAM_SDQS1_N: C14.2, C16.2, U1.T2 (DRAM_SDQS1_N), U2.B7 (UDQS#)
/imx_mpu/mpu_b_dram/DRAM_SDQS1_P: C14.1, C16.1, U1.T1 (DRAM_SDQS1_P), U2.C7 (UDQS)
/imx_mpu/mpu_b_dram/DRAM_UDM: U1.T3 (DRAM_DQM1), U2.D3 (UDM)
/imx_mpu/mpu_b_dram/DRAM_WE: U1.J1 (DRAM_SDWE_B), U2.L3 (WE#)
/imx_mpu/mpu_b_dram/Dram_vref: C8.2, C9.1, C10.1, C11.1, C12.1, R3.2, R4.1, U1.P4 (DRAM_VREF), U2.H1 (VREFDQ), U2.M8 (VREFCA)
Dram_1V35: C7.1, C8.1, R3.1, U1.G6 (NVCC_DRAM), U1.H6 (NVCC_DRAM), U1.J6 (NVCC_DRAM), U1.K6 (NVCC_DRAM), U1.L6 (NVCC_DRAM), U1.M6 (NVCC_DRAM), U2.A1 (VDDQ), U2.A8 (VDDQ), U2.B2 (VDD), U2.C1 (VDDQ), U2.C9 (VDDQ), U2.D2 (VDDQ), U2.D9 (VDD), U2.E9 (VDDQ), U2.F1 (VDDQ), U2.G7 (VDD), U2.H2 (VDDQ), U2.H9 (VDDQ), U2.K2 (VDD), U2.K8 (VDD), U2.N1 (VDD), U2.N9 (VDD), U2.R1 (VDD), U2.R9 (VDD); also elsewhere on the board
GND: C7.2, C9.2, C10.2, C11.2, C12.2, C13.2, R4.2, R5.2, R6.2, R7.2, U2.A9 (VSS), U2.B1 (VSSQ), U2.B3 (VSS), U2.B9 (VSSQ), U2.D1 (VSSQ), U2.D8 (VSSQ), U2.E1 (VSS), U2.E2 (VSSQ), U2.E8 (VSSQ), U2.F9 (VSSQ), U2.G1 (VSSQ), U2.G8 (VSS), U2.G9 (VSSQ), U2.J2 (VSS), U2.J8 (VSS), U2.M1 (VSS), U2.M9 (VSS), U2.P1 (VSS), U2.P9 (VSS), U2.T1 (VSS), U2.T9 (VSS); also elsewhere on the board
unnamed: R5.1, U1.N4 (DRAM_ZQPAD)
unnamed: R7.1, U2.L8 (ZQ)
unnamed: U1.G2 (DRAM_ADDR06), U2.R8 (A6)
unnamed: U1.H2 (DRAM_ADDR01), U2.P7 (A1)
unnamed: U1.H4 (DRAM_ADDR07), U2.R2 (A7)
unnamed: U1.J4 (DRAM_ADDR08), U2.T8 (A8)
unnamed: U1.K1 (DRAM_ADDR02), U2.P3 (A2)
unnamed: U1.K3 (DRAM_ADDR11), U2.R7 (A11)
unnamed: U1.K4 (DRAM_ADDR04), U2.P8 (A4)
unnamed: U1.L1 (DRAM_ADDR05), U2.P2 (A5)
unnamed: U1.L2 (DRAM_ADDR09), U2.R3 (A9)
unnamed: U1.L4 (DRAM_ADDR12), U2.N7 (A12/BC#)
unnamed: U1.L5 (DRAM_ADDR00), U2.N3 (A0)
unnamed: U1.M2 (DRAM_ADDR03), U2.N2 (A3)
unnamed: U1.M4 (DRAM_ADDR10), U2.L7 (A10/AP)
VDD_HIGH_CAP: C13.1, U1.N6 (NVCC_DRAM_2P5)

Notes on the sheet:
Place 0.22us near DRAM pins
Place Near DRAM
DRAM VREF

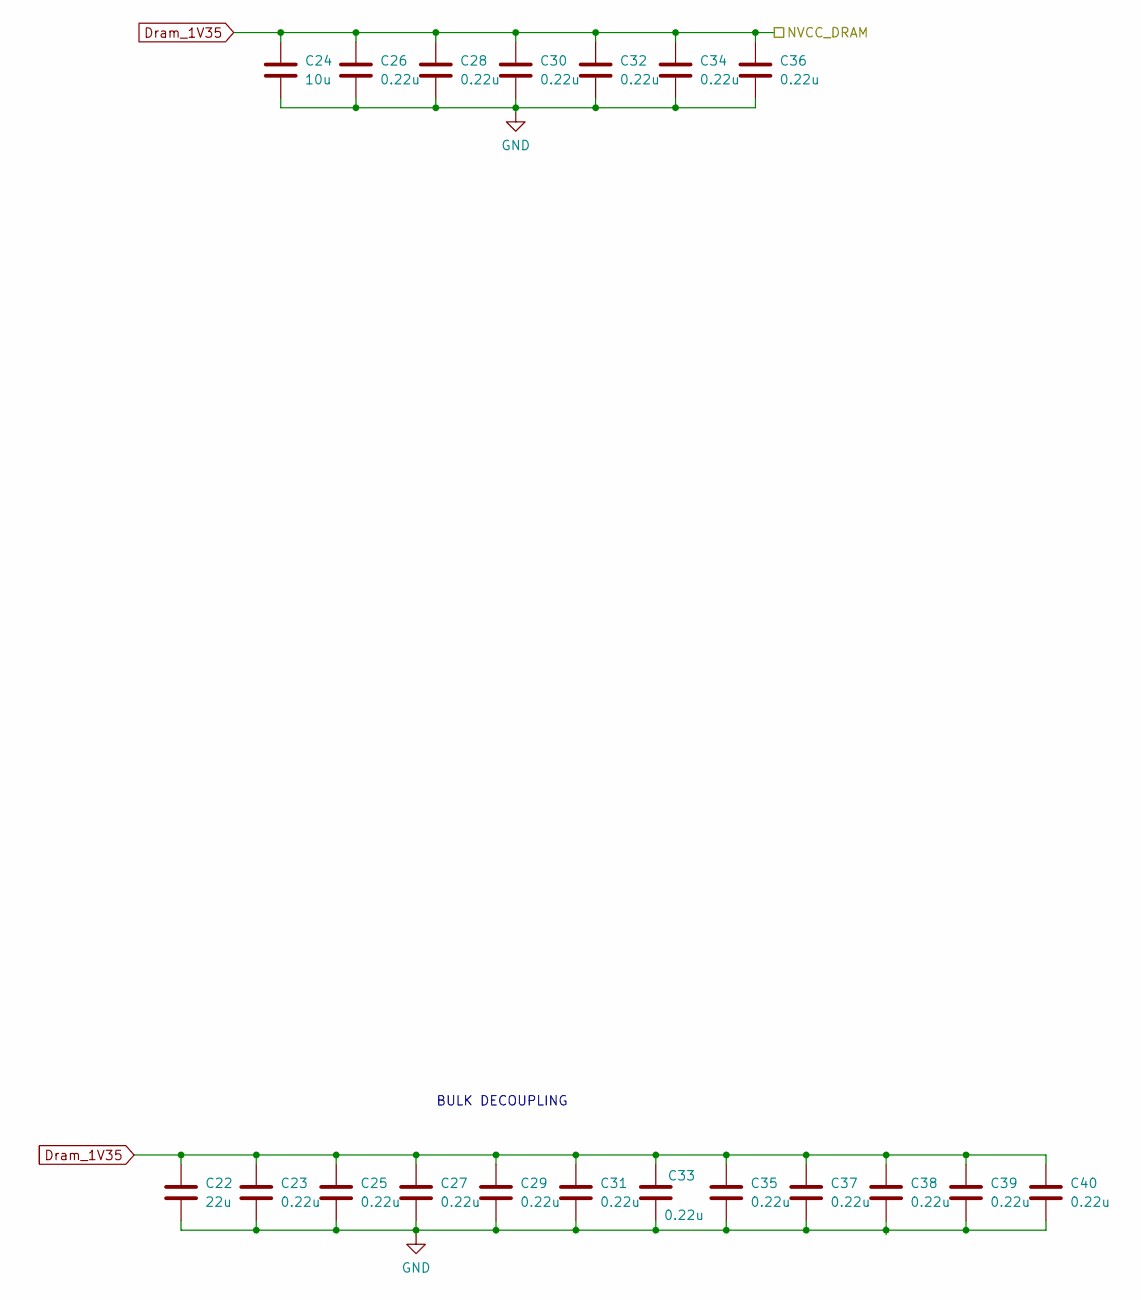
[picture p14: schematic dram_decoupling.kicad_sch]

Parts:
C22: 22u; C_0805_2012Metric
C23, C25, C26, C27, C28, C29, C30, C31, C32, C33, C34, C35, C36, C37, C38, C39, C40: 0.22u; C_0402_1005Metric
C24: 10u; C_0805_2012Metric

Connections:
Dram_1V35: C22.1, C23.1, C24.1, C25.1, C26.1, C27.1, C28.1, C29.1, C30.1, C31.1, C32.1, C33.1, C34.1, C35.1, C36.1, C37.1, C38.1, C39.1, C40.1; also elsewhere on the board
GND: C22.2, C23.2, C24.2, C25.2, C26.2, C27.2, C28.2, C29.2, C30.2, C31.2, C32.2, C33.2, C34.2, C35.2, C36.2, C37.2, C38.2, C39.2, C40.2; also elsewhere on the board

Notes on the sheet:
BULK DECOUPLING

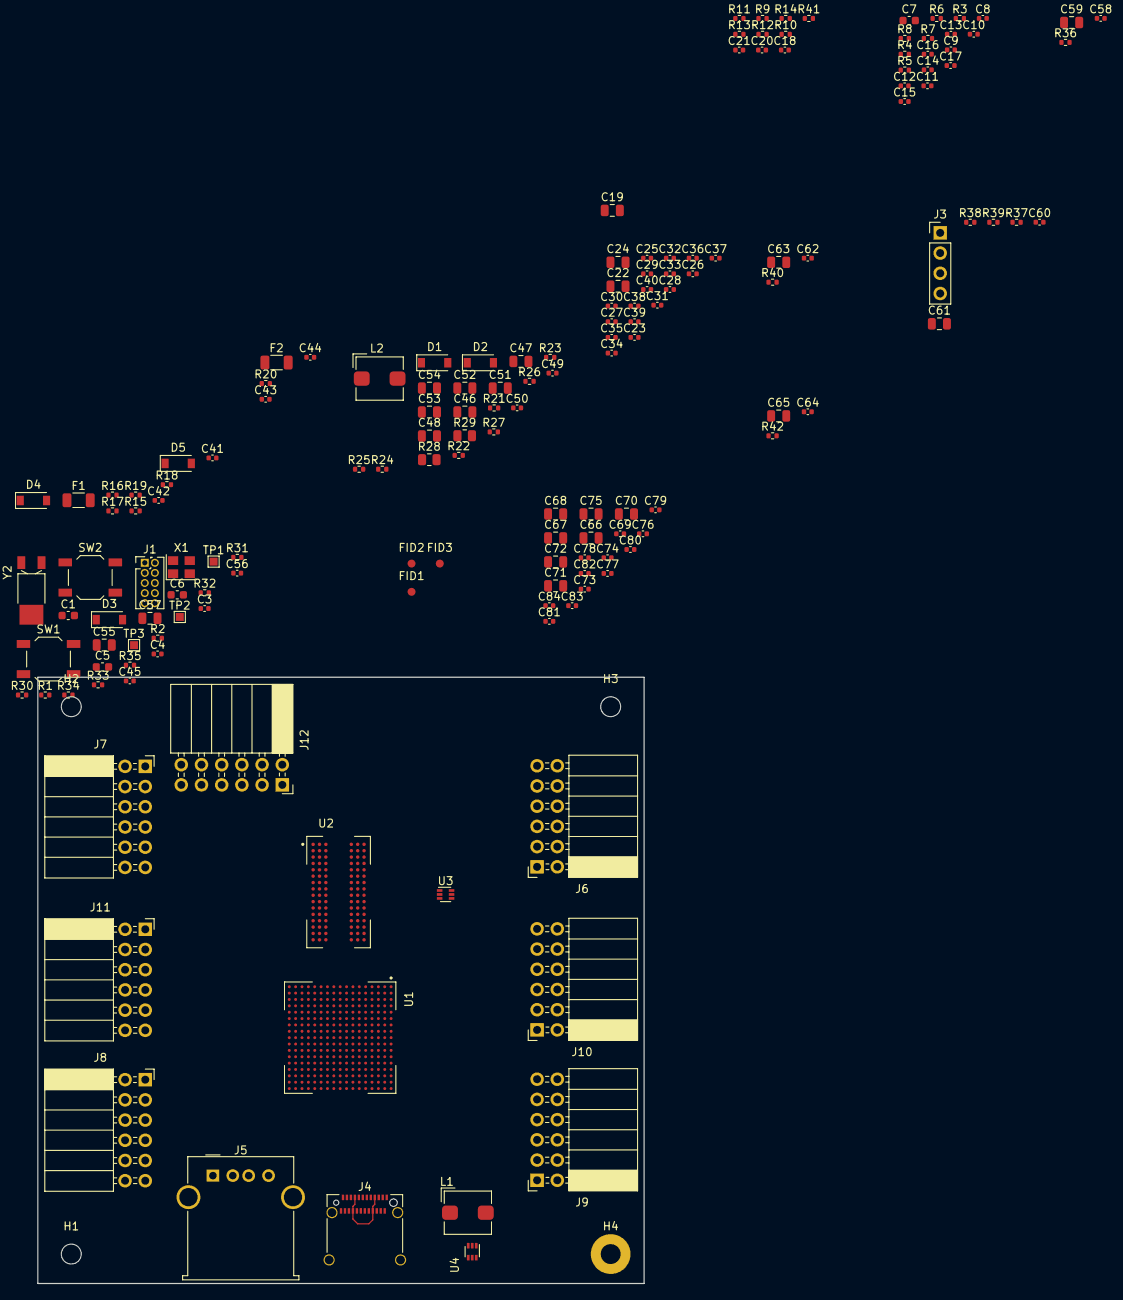
[picture p15: board imx_pequena.kicad_pcb from above]

Board: 6 copper layers, 76.2 x 76.2 mm, 164 parts (1 on the bottom side), 165 nets.
