Matthew-Bon/imx_pequena/(commit log)

2023-06-09 Updated DRAM
    DRAM Schematic tentatively done
    [dram_decoupling.kicad_sch, imx_mpu.kicad_sch, imx_pequena.kicad_sch, mpu_b_dram.kicad_sch]
2023-06-10 SD card + pinot files
    [dram_decoupling.kicad_sch, imx_mpu.kicad_sch, imx_pequena.kicad_sch, mpu_b_dram.kicad_sch, mpu_d_uart.kicad_sch, mpu_f_sd.kicad_sch]
2023-06-11 Started IO section
    began adding crystals
    [dram_decoupling.kicad_sch, imx_mpu.kicad_sch, imx_pequena.kicad_sch, mpu_a_io.kicad_sch]
2023-06-12 misc changes
    usb nets, crystal caps, etc...
    [dram_decoupling.kicad_sch, imx_mpu.kicad_sch, imx_pequena.kicad_sch, mpu_a_io.kicad_sch]
2023-09-03 USB Updates
    Back in the saddle after moving. Added USB C and USB OTG symbols and supporting passives.
    [imx_mpu.kicad_sch, imx_pequena.kicad_sch, imx_usb.kicad_sch, mpu_b_dram.kicad_sch, untitled.kicad_sch]
2023-11-19 Power Update
    Added 3v3 and 1.35V switchers
    [dram_decoupling.kicad_sch, imx_pequena.kicad_sch, imx_usb.kicad_sch, mpu_a_io.kicad_sch, mpu_b_dram.kicad_sch, mpu_d_uart.kicad_sch, mpu_f_sd.kicad_sch, mpu_h_power.kicad_sch]
2023-12-02 Updated config
    Updated config file and some pins
    [imx_pequena.kicad_sch, mpu_a_io.kicad_sch, mpu_b_dram.kicad_sch, mpu_d_uart.kicad_sch, power.kicad_sch]
2023-12-11 Power upates
    Added connections to power pins and decoupling caps
    [imx_mpu.kicad_sch, imx_pequena.kicad_sch, mpu_a_io.kicad_sch, mpu_h_power.kicad_sch, power.kicad_sch]
2024-01-13 Updated reset pins
    Updated reset pins
    [imx_pequena.kicad_pcb, imx_pequena.kicad_sch, mpu_a_io.kicad_sch]
2024-01-15 Cleaned up NVCC pins
    Added 3v3 connections + decoupling caps to NVcc pins
    [imx_pequena.kicad_sch, imx_usb.kicad_sch, mpu_a_io.kicad_sch, mpu_c_gpio.kicad_sch, mpu_d_uart.kicad_sch, mpu_e_nand.kicad_sch, mpu_f_sd.kicad_sch, mpu_g_kpp.kicad_sch]
2024-01-15 Updated pin mappings
    [imx_pequena.kicad_sch, mpu_a_io.kicad_sch, mpu_f_sd.kicad_sch]
2024-01-16 Updated pinouts
    Added misc uart changes
    [imx_mpu.kicad_sch, imx_pequena.kicad_sch, mpu_d_uart.kicad_sch, mpu_e_nand.kicad_sch, pinouts.kicad_sch]
2024-01-28 Pinout updates
    Updated pinout files, changed pinout of gpio 1 and 3
    [imx_pequena.kicad_sch, imx_usb.kicad_sch, mpu_b_dram.kicad_sch, mpu_c_gpio.kicad_sch, mpu_g_kpp.kicad_sch, pinouts.kicad_sch]
2024-01-28 Added test points
    added test points
    [imx_pequena.kicad_sch, mpu_a_io.kicad_sch, pinouts.kicad_sch]
2024-02-08 Part Assignment
    Assigned GPIOs and assigned footprints to most parts
    [dram_decoupling.kicad_sch, imx_mpu.kicad_sch, imx_pequena.kicad_pcb, imx_pequena.kicad_sch, imx_usb.kicad_sch, mpu_a_io.kicad_sch, mpu_b_dram.kicad_sch, mpu_c_gpio.kicad_sch]
2024-02-18 lots of updates
    Set design rules, fixed ERC, etc....
    [dram_decoupling.kicad_sch, imx_mpu.kicad_sch, imx_pequena.kicad_pcb, imx_pequena.kicad_sch, imx_usb.kicad_sch, mpu_a_io.kicad_sch, mpu_b_dram.kicad_sch, mpu_c_gpio.kicad_sch]
2024-02-29 Layout updates
    moved pmod connectors
    [imx_pequena.kicad_pcb]
2024-03-02 fixed part alllocation
    fixed socket to pin header issue
    [dram_decoupling.kicad_sch, imx_pequena.kicad_pcb, imx_pequena.kicad_sch, imx_usb.kicad_sch, mpu_a_io.kicad_sch, mpu_b_dram.kicad_sch, mpu_c_gpio.kicad_sch, mpu_d_uart.kicad_sch]
